jonaskaz/3D-Scanner/(commit log)

2021-09-18 MP2 Sensor Read & Servo
    Added pan and tilt of servos
2021-09-24 Add linear path arduino code
2021-09-28 Update scanner with data and filtering
2021-09-29 Created sketch for 1 servo scan
2021-09-30 Add multiplier and fix plotting
    [LinearPath.ino, live_plot.py, read_data.py]
